VibrasticLab/wesel_monitoring/documents/devsummary_v0/images/goal_diagram/downloads/laptop.png

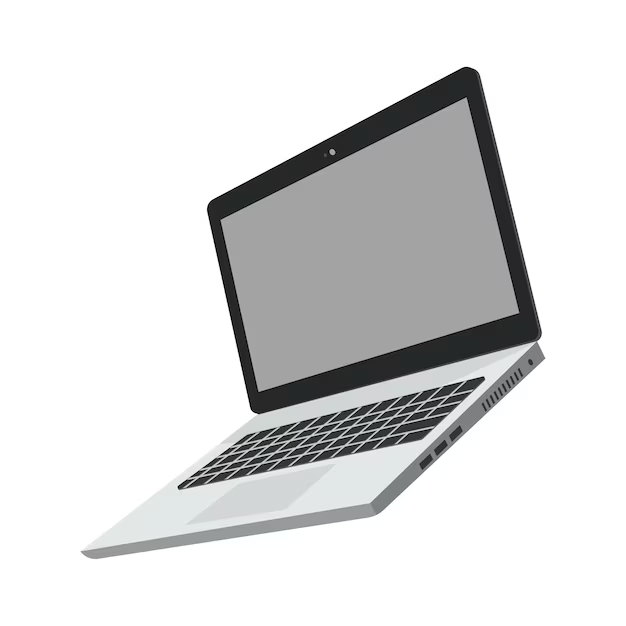
documents/devsummary_v0/images/goal_diagram/downloads/laptop.png
