VibrasticLab/wesel_monitoring/documents/devsummary_v0/images/goal_diagram/downloads/pc.png

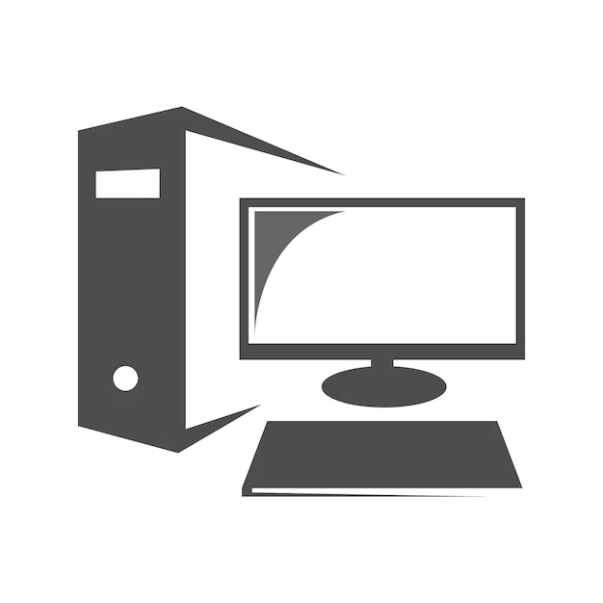
documents/devsummary_v0/images/goal_diagram/downloads/pc.png
