VibrasticLab/wesel_monitoring/documents/devsummary_v0/images/goal_diagram/downloads/ra02.jpg

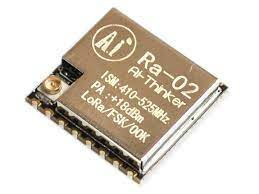
documents/devsummary_v0/images/goal_diagram/downloads/ra02.jpg
