VibrasticLab/wesel_monitoring/documents/devsummary_v0/images/goal_diagram/downloads/railway.jpeg

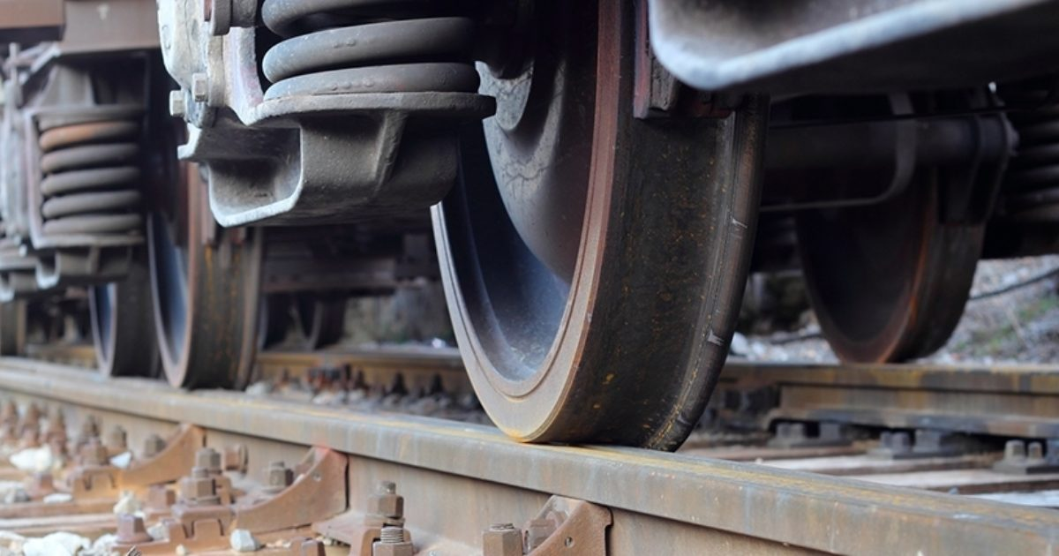
documents/devsummary_v0/images/goal_diagram/downloads/railway.jpeg
