VibrasticLab/wesel_monitoring/documents/devsummary_v0/images/goal_diagram/downloads/stm32.png

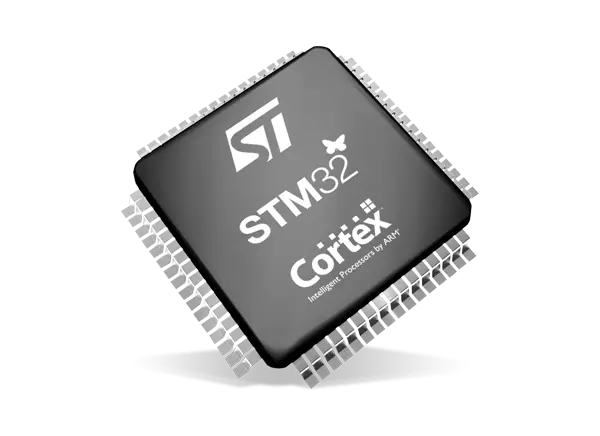
documents/devsummary_v0/images/goal_diagram/downloads/stm32.png
