VibrasticLab/wesel_monitoring/documents/devsummary_v0/images/goal_diagram/downloads/te850m1.jpg

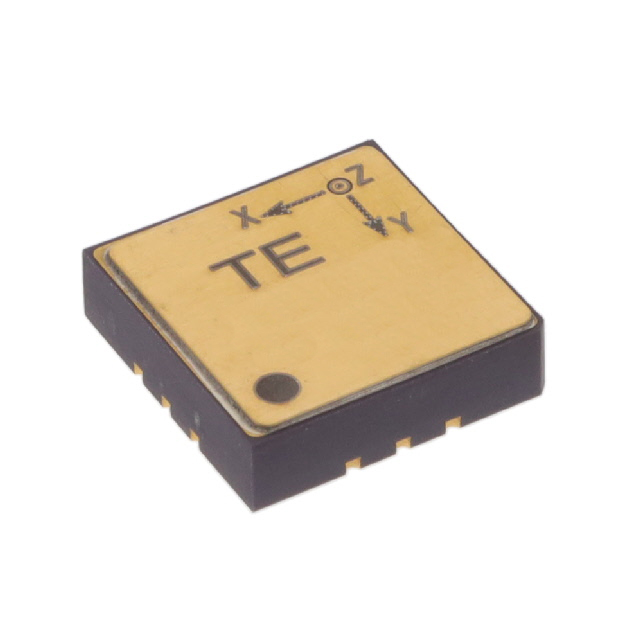
documents/devsummary_v0/images/goal_diagram/downloads/te850m1.jpg
