VibrasticLab/wesel_monitoring/documents/devsummary_v0/images/goal_diagram/downloads/uart.jpg

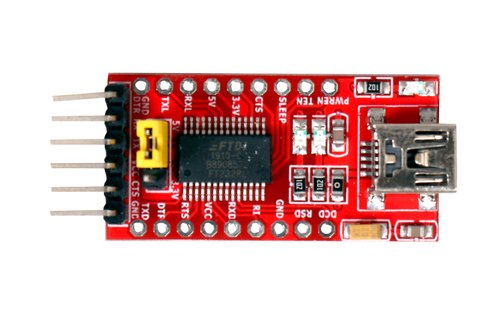
documents/devsummary_v0/images/goal_diagram/downloads/uart.jpg
