VibrasticLab/wesel_monitoring/documents/devsummary_v0/images/goal_diagram/downloads/usblora.jpg

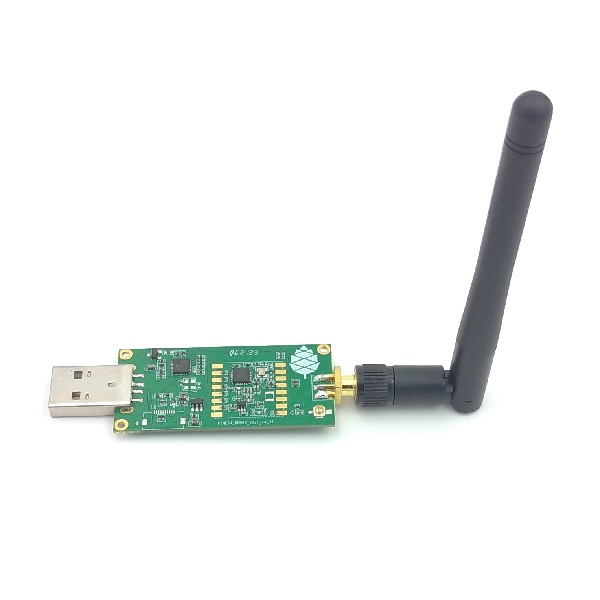
documents/devsummary_v0/images/goal_diagram/downloads/usblora.jpg
