VibrasticLab/wesel_monitoring/documents/devsummary_v0/images/lora/lora.jpg

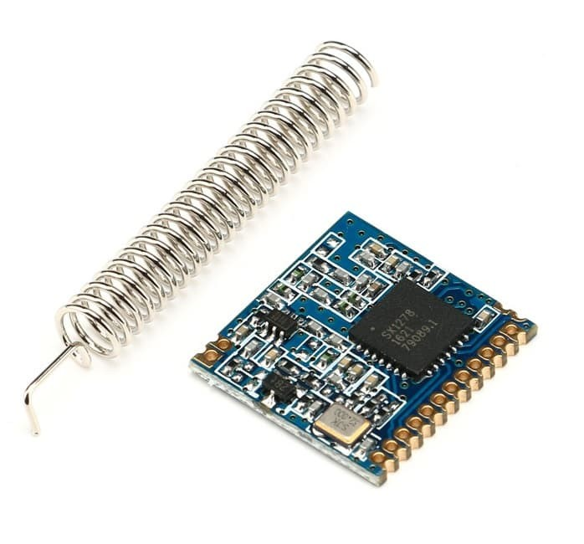
documents/devsummary_v0/images/lora/lora.jpg
