VibrasticLab/wesel_monitoring/documents/devsummary_v0/images/lora/nano.jpg

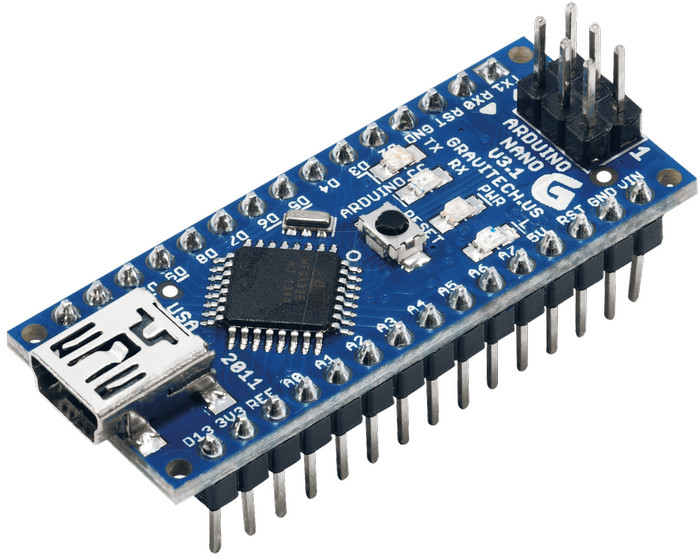
documents/devsummary_v0/images/lora/nano.jpg
