VibrasticLab/wesel_monitoring/documents/devsummary_v0/images/lora/pl2303.jpg

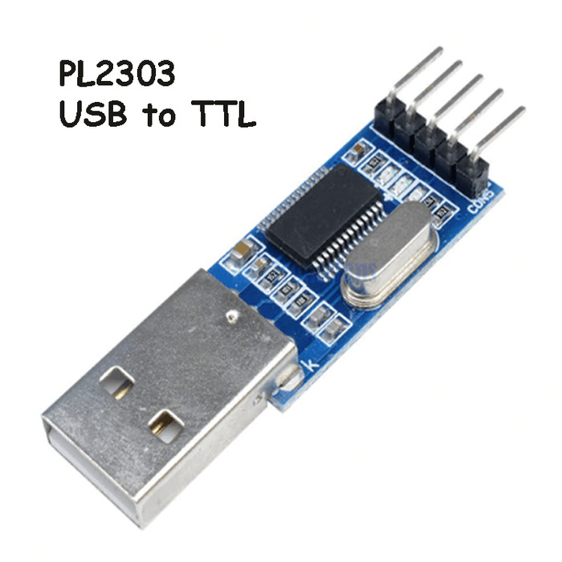
documents/devsummary_v0/images/lora/pl2303.jpg
