VibrasticLab/wesel_monitoring/documents/diagram/images/adxl345.jpg

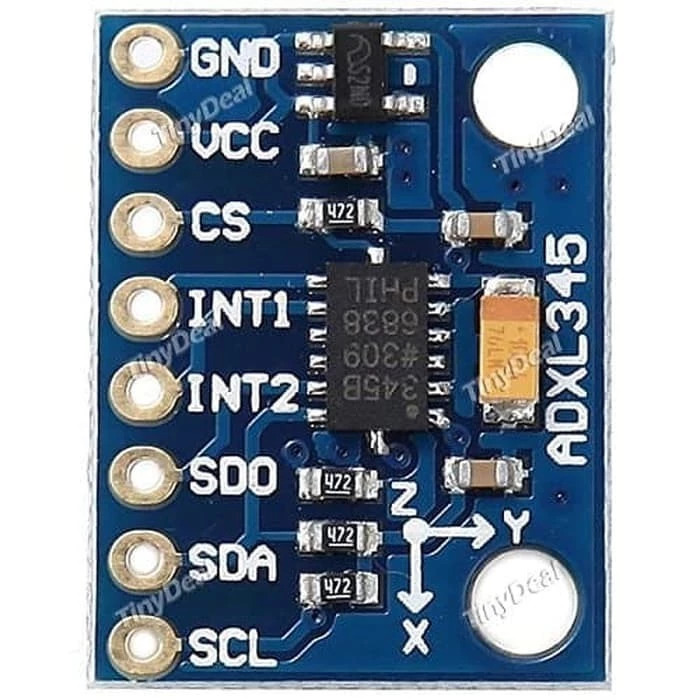
documents/diagram/images/adxl345.jpg
