VibrasticLab/wesel_monitoring/documents/diagram/images/batt.jpg

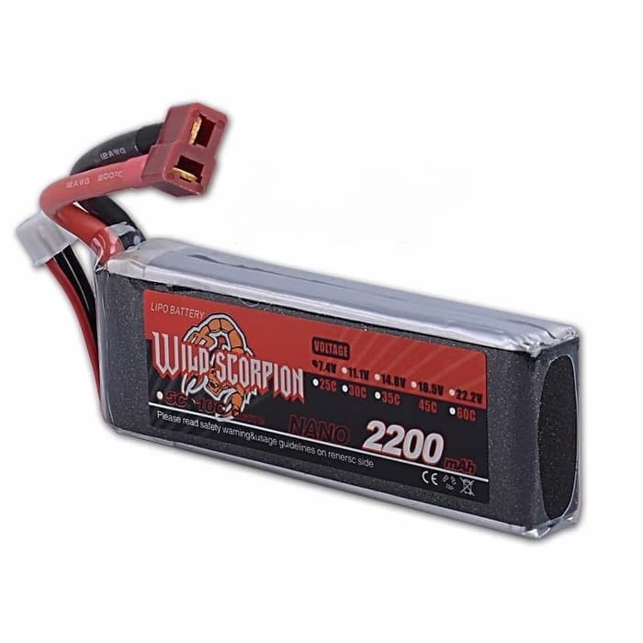
documents/diagram/images/batt.jpg
