VibrasticLab/wesel_monitoring/documents/diagram/images/digiducer.jpg

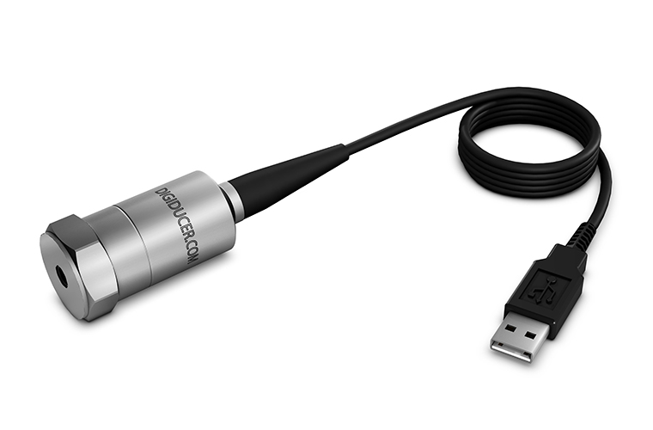
documents/diagram/images/digiducer.jpg
