VibrasticLab/wesel_monitoring/documents/diagram/images/endaq.jpg

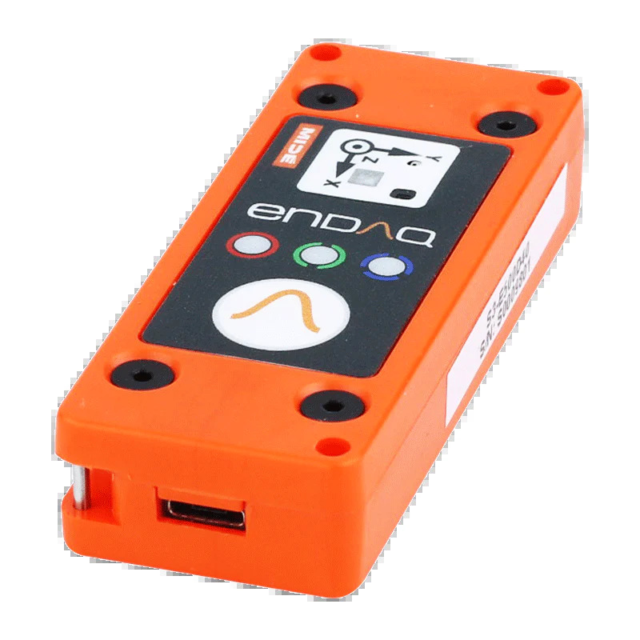
documents/diagram/images/endaq.jpg
