VibrasticLab/wesel_monitoring/documents/diagram/images/hmc6343.jpg

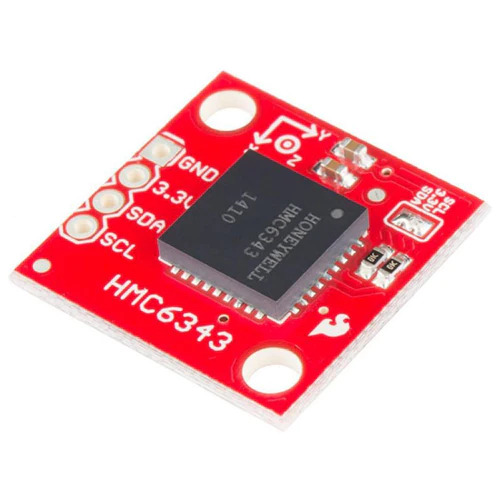
documents/diagram/images/hmc6343.jpg
