VibrasticLab/wesel_monitoring/documents/diagram/images/ldt0-028.png

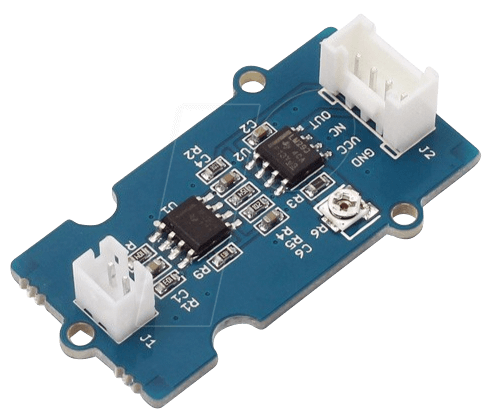
documents/diagram/images/ldt0-028.png
