VibrasticLab/wesel_monitoring/documents/diagram/images/lora.jpg

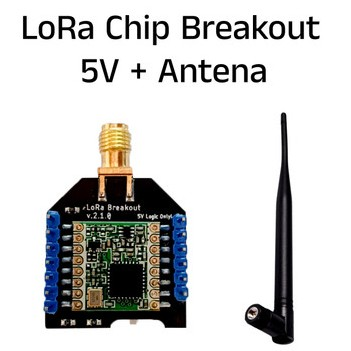
documents/diagram/images/lora.jpg
