VibrasticLab/wesel_monitoring/documents/diagram/images/mpu6050.jpg

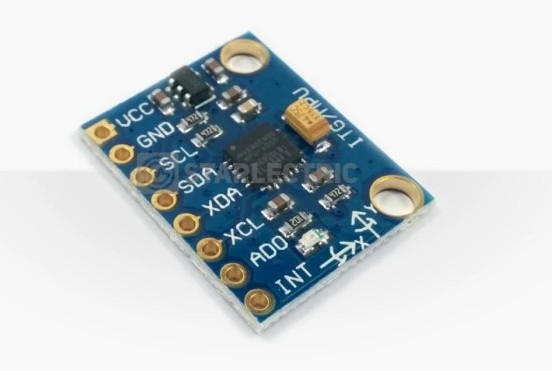
documents/diagram/images/mpu6050.jpg
