VibrasticLab/wesel_monitoring/documents/diagram/images/nimodule.jpg

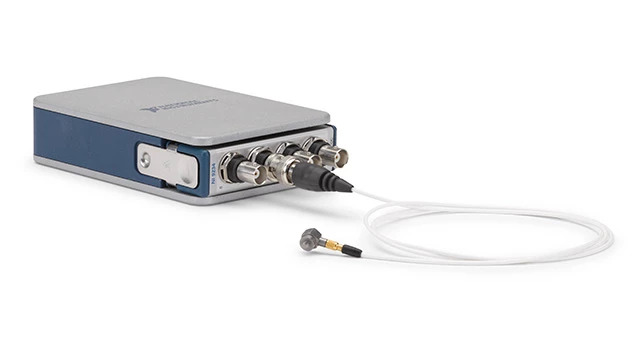
documents/diagram/images/nimodule.jpg
