VibrasticLab/wesel_monitoring/documents/diagram/images/nodemcu.jpg

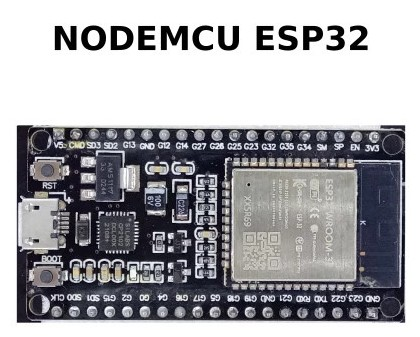
documents/diagram/images/nodemcu.jpg
