VibrasticLab/wesel_monitoring/documents/diagram/images/proxysen.jpg

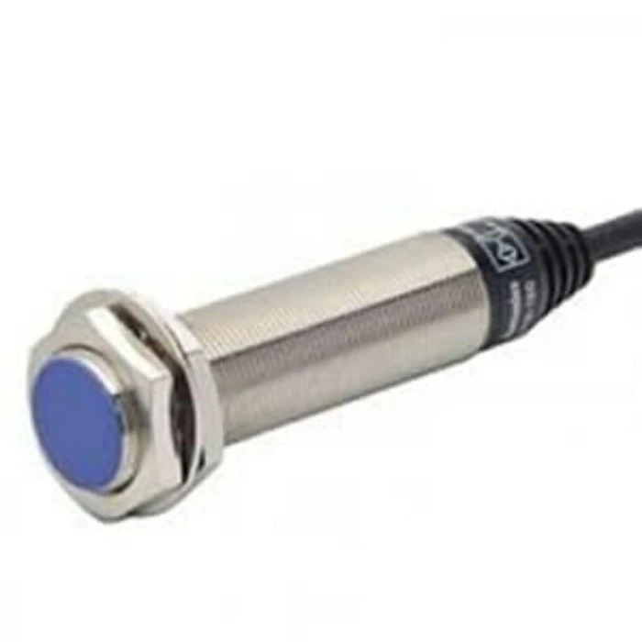
documents/diagram/images/proxysen.jpg
