VibrasticLab/wesel_monitoring/documents/diagram/images/sw420.jpg

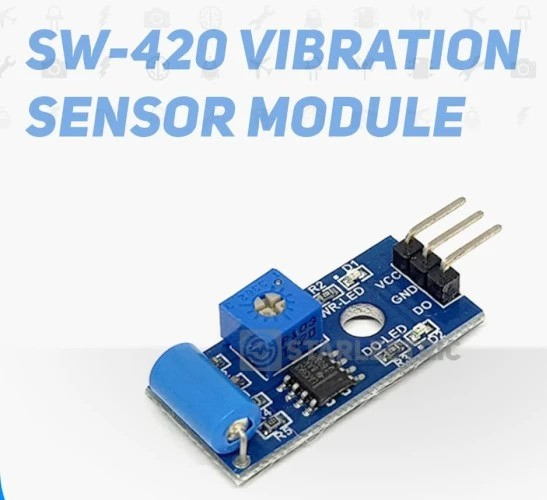
documents/diagram/images/sw420.jpg
