VibrasticLab/wesel_monitoring/documents/diagram/images/voltreg.jpg

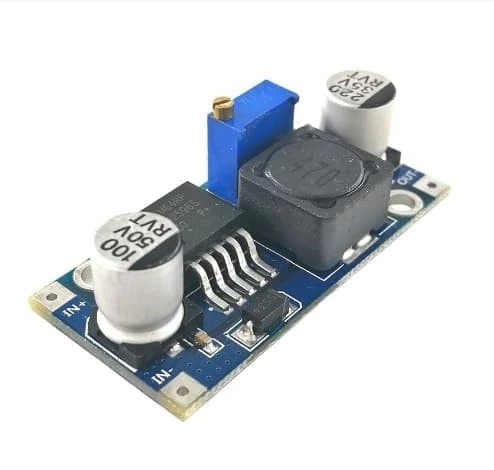
documents/diagram/images/voltreg.jpg
