VibrasticLab/wesel_monitoring/documents/diagram/kai_planning.png

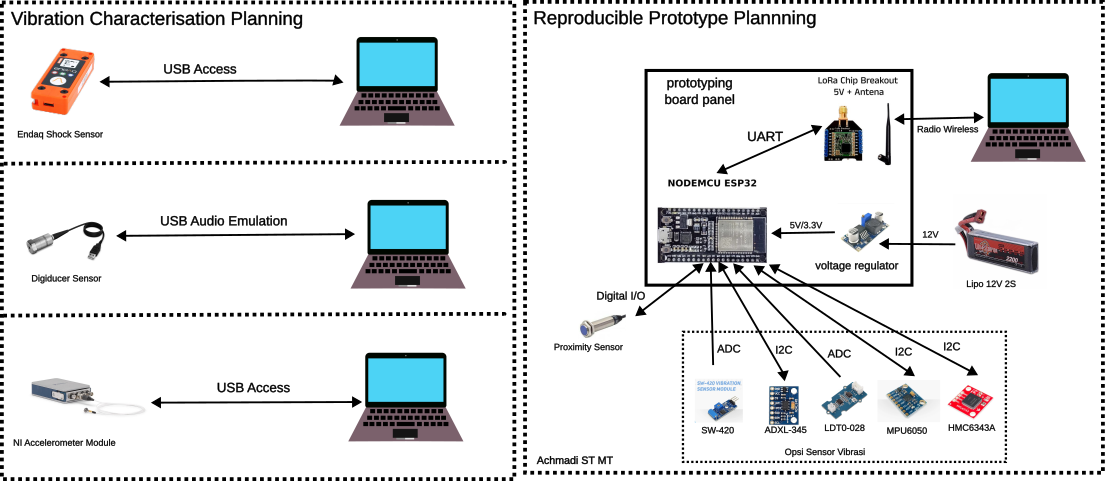
documents/diagram/kai_planning.png
