VibrasticLab/wesel_monitoring/documents/summary_v0/images/hantek_osci.png

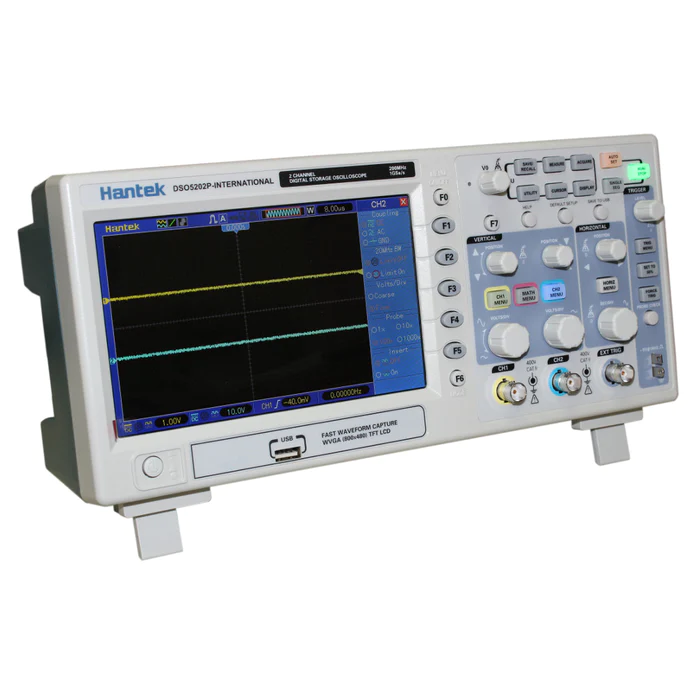
documents/summary_v0/images/hantek_osci.png
