VibrasticLab/wesel_monitoring/documents/summary_v0/images/hantex_siggen.jpg

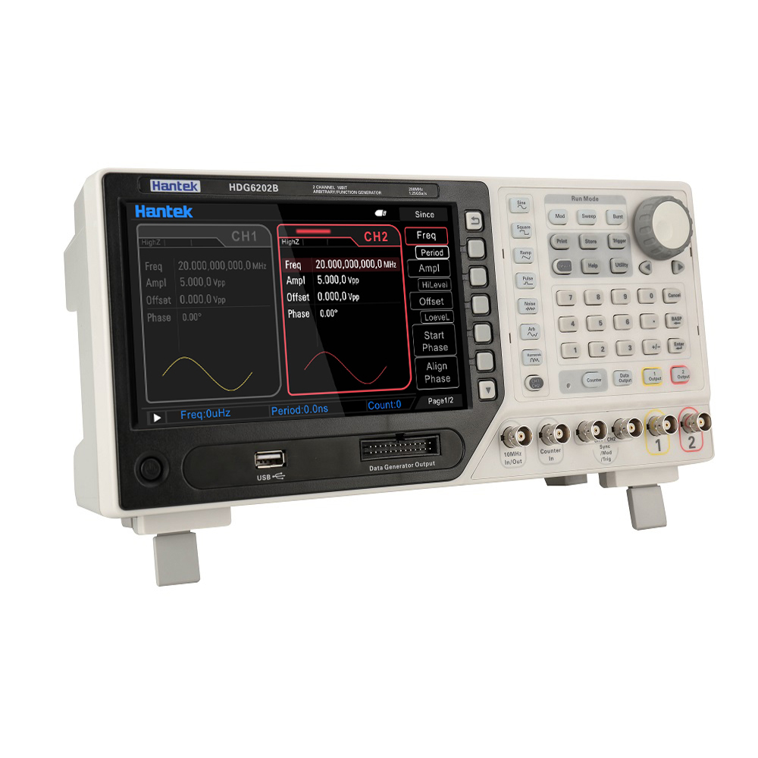
documents/summary_v0/images/hantex_siggen.jpg
