VibrasticLab/wesel_monitoring/documents/summary_v0/images/vibgen.png

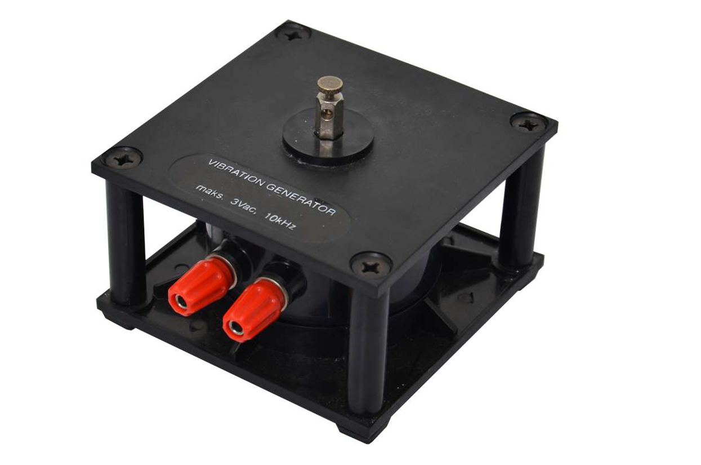
documents/summary_v0/images/vibgen.png
