VibrasticLab/wesel_monitoring/documents/cost_estimation_v0/BiayaDev.ods

Item | Total | Toko | URL
PCB Versi 1 | 238,500.00 IDR |  | https://www.tokopedia.com/geraicerdas/cetak-pcb-1-keping-single-double-layer-rapid-prototyping-satuan
FTDI DevBoard | 18,000.00 IDR | Nota Hilang | https://www.tokopedia.com/dx-tronics/ft232-usb-to-ttl-serial-3-3v-5v-ftdi-ft232rl
Kotak Plastik | 21,500.00 IDR | Sakinah
USB Ext 2m | 15,000.00 IDR | Sakinah
Stop Kontak | 94,000.00 IDR | Alfamart
Antena LoRA | 40,000.00 IDR | Mulsanne
Lem 3D Printer | 26,000.00 IDR | Sakinah
Akomodasi Ambil Impor | 250,000.00 IDR | Motor Mogok
Total | 703,000.00 IDR
