VibrasticLab/wesel_monitoring/documents/summary_v0/images/parts.png

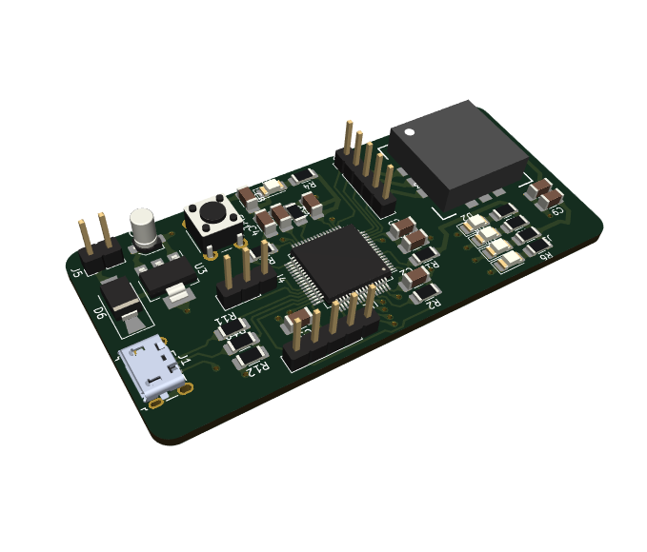
documents/summary_v0/images/parts.png
