VibrasticLab/wesel_monitoring/circuit/casing_vibs/casing_upper-cut.stl

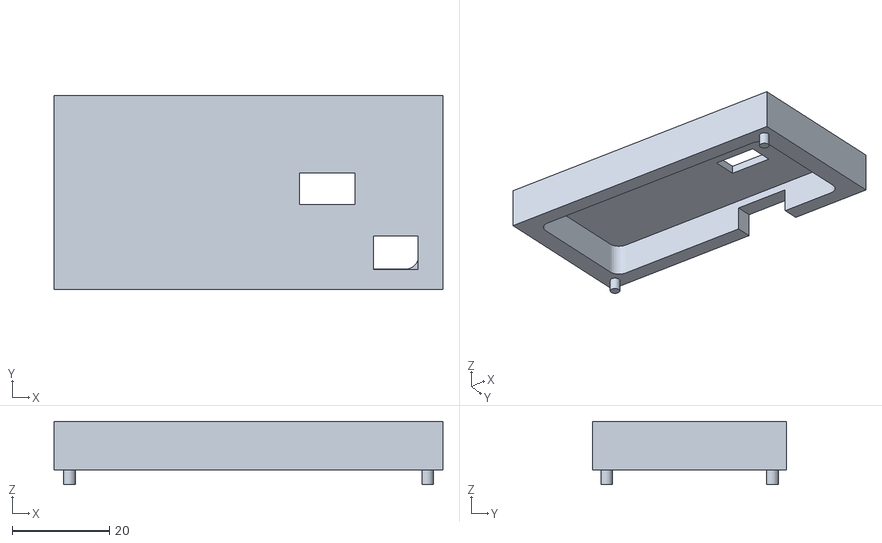
[picture p47: CAD file, 2024-01-16]
circuit/casing_vibs/casing_upper-cut.stl
80.0 x 40.0 x 13.0
