VibrasticLab/wesel_monitoring/circuit/casing_vibs/casing_upper.FCStd

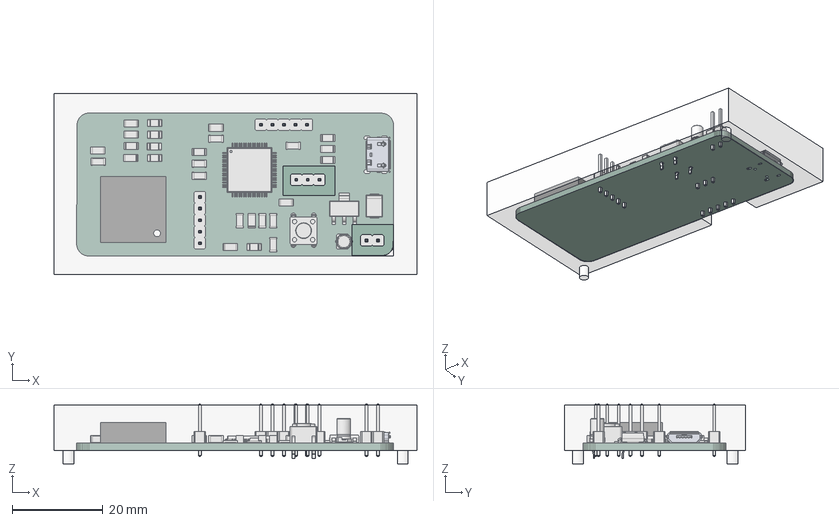
[picture p48: CAD file, 2024-01-16]
circuit/casing_vibs/casing_upper.FCStd
80.0 x 40.0 x 13.2 mm
mems_vibs PCB
