VibrasticLab/wesel_monitoring/circuit/casing_vibs/casing_2.FCStd

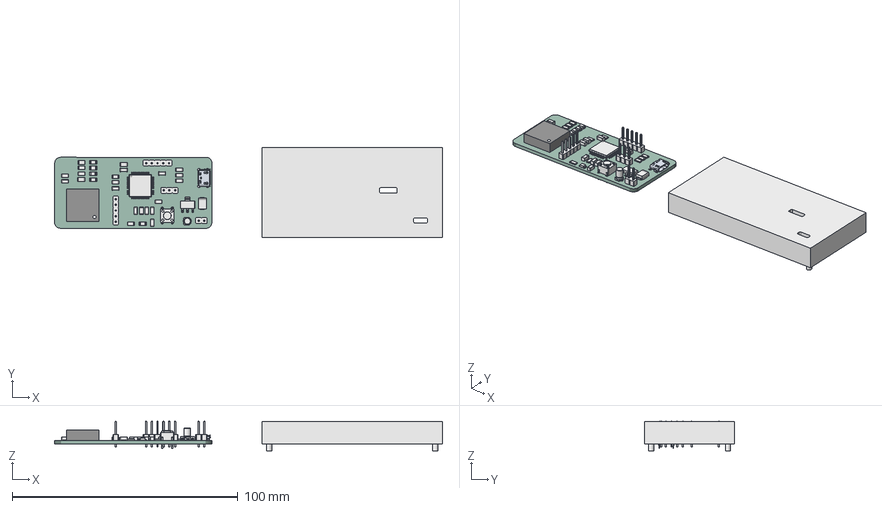
[picture p49: CAD file, 2023-12-20]
circuit/casing_vibs/casing_2.FCStd
172.0 x 40.0 x 13.2 mm
mems_vibs PCB
upper_part
