VibrasticLab/wesel_monitoring/circuit/casing_vibs/casing.FCStd

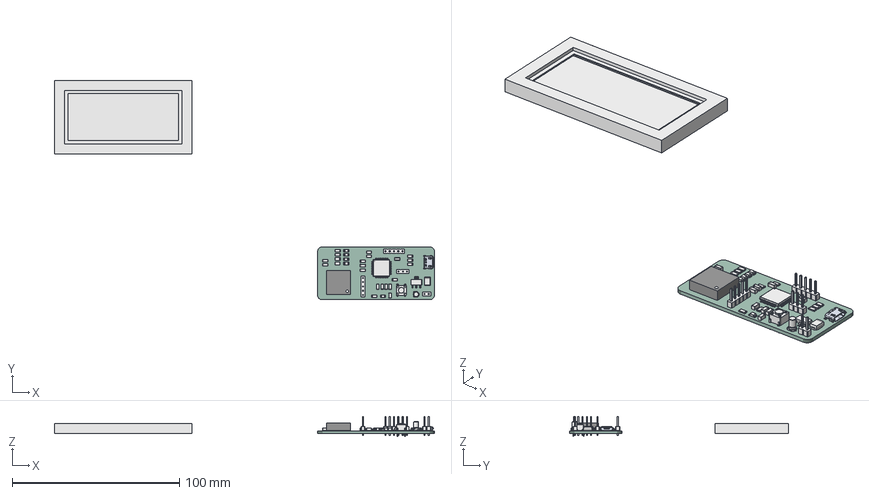
[picture p50: CAD file, 2023-12-20]
circuit/casing_vibs/casing.FCStd
226.9 x 131.0 x 12.0 mm
mems_vibs PCB
bottom_pad
BooleanFragments
