VibrasticLab/wesel_monitoring/circuit/casing_vibs/casing_2-bottom_part.stl

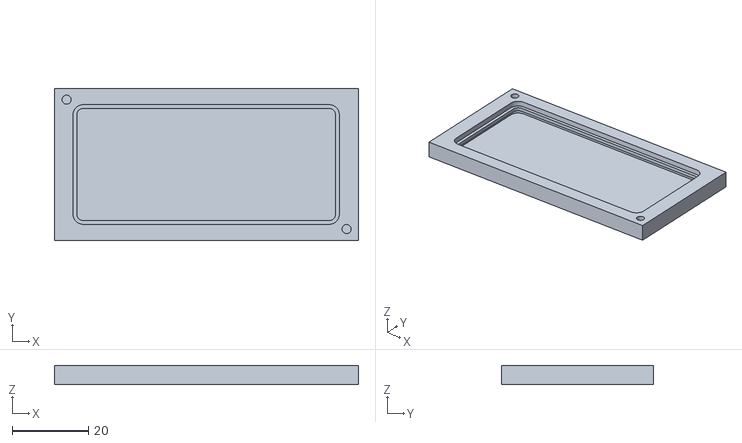
[picture p51: CAD file, 2023-12-15]
circuit/casing_vibs/casing_2-bottom_part.stl
80.0 x 40.0 x 5.00
