VibrasticLab/wesel_monitoring/(list of files, cad)

Other CAD files:
circuit/casing_vibs/casing_2-upper_part.stl
