VibrasticLab/wesel_monitoring/firmware/vib/main.c

/**
 * @file main.c
 * @brief Main Entry code
 *
 * @addtogroup Main
 * @{
 */

#include "vib_includes.h"

/*
 * Red LED blinker thread, times are in milliseconds.
 */
static THD_WORKING_AREA(waThread1, 128);
static THD_FUNCTION(Thread1, arg) {

  (void)arg;
  chRegSetThreadName("blinker");
  while (true) {
    palSetPad(GPIOB, 3);
    palClearPad(GPIOB, 4);
    palClearPad(GPIOB, 6);
    chThdSleepMilliseconds(500);
    palClearPad(GPIOB, 3);
    palSetPad(GPIOB, 4);
    palSetPad(GPIOB, 6);
    chThdSleepMilliseconds(500);
  }
}

/*
 * Application entry point.
 */
int main(void) {

  halInit();
  chSysInit();

#if VIB_USE_ANALOG
  vib_Analog_Init();
#endif

#if VIB_USE_SERIAL
  vib_Serial_Init();
#endif

#if VIB_USE_USB
  vib_USBSerial_Init();
#endif

#if VIB_USE_SHELL
  vib_Shell_Init();
#endif

  /*
   * Creates the blinker thread.
   */
  palSetPadMode(GPIOB, 3, PAL_MODE_OUTPUT_PUSHPULL);
  palSetPadMode(GPIOB, 4, PAL_MODE_OUTPUT_PUSHPULL);
  palSetPadMode(GPIOB, 6, PAL_MODE_OUTPUT_PUSHPULL);
  chThdCreateStatic(waThread1, sizeof(waThread1), NORMALPRIO, Thread1, NULL);

  while (true) {
#if VIB_USE_SHELL
    vib_Serial_Loop();
#endif

#if VIB_USE_USB
    vib_USBSerial_Loop();
#endif
    chThdSleepMilliseconds(500);
  }
}

/** @}*/
