VibrasticLab/wesel_monitoring/(commit log)

2023-05-19 Trial Circuit
    [mems_vibs.kicad_pcb, mems_vibs.kicad_sch]
2023-05-19 MEMS Sens
    [mems_vibs.kicad_sch]
2023-05-19 Use STM32F103RB as base chip
    [mems_vibs.kicad_sch]
2023-05-19 Basic Chip
    [mems_vibs.kicad_sch]
2023-05-19 Progress PCB KAI
    [mems_vibs.kicad_sch]
2023-05-23 Prototype awal
    [mems_vibs.kicad_sch]
2023-05-23 Schematic Progress
    [mems_vibs.kicad_sch]
2023-05-23 PCB Awal
    [mems_vibs.kicad_pcb, mems_vibs.kicad_sch]
2023-09-07 USB Serial crashed on ADC DMA
    [halconf.h, main.c, mcuconf.h, vib_analog.c, vib_includes.h, vib_serial.c, vib_serial.h]
2023-09-11 Summary v0
    [mems_vibs.kicad_sch]
2023-11-10 Update PCB
    [mems_lora.kicad_pcb]
2023-11-11 Rangkuman Pengembangan
    [mems_lora.kicad_pcb]
2023-11-12 Prepare Calibration Test
2023-11-12 add save button
    [data.csv]
2023-11-12 get wrong in converted bit
    [serialplot.py]
2023-11-13 Some interface improvements
    [data.csv]
2023-11-14 update on ADC calculation
2023-11-14 add calibration note
2023-12-03 Order PCB
    [mems_lora.kicad_pcb]
2023-12-15 bottom casing drafted
    [casing-BooleanFragments.stl, casing_2-bottom_part.stl, data.csv]
2023-12-20 finished casing
    [casing-BooleanFragments.stl, casing.FCStd, casing_2-upper_part.stl, casing_2.FCStd]
2024-01-16 New Case
    [casing_upper-cut.stl, casing_upper.FCStd]
2024-01-29 soldering drive me crazy
    [mems_lora.kicad_sch]
